CameronBrooks11/geodesic-dome/(list of files, cad)

Other CAD files:
connector.scad
connector_v1.scad
connector_v2.scad
