CameronBrooks11/geodesic-dome/(commit log)

2025-05-18 initial commit of connector concept
    [connector.scad]
2025-05-18 added attrib line
    [connector.scad]
2025-05-18 connector v2, moving towards more uniform and readily parameterizable
    [connector_v1.scad, connector_v2.scad]
2025-05-19 redid center piece to be cleaner and readily parametric
    [connector_v2.scad]
2025-05-19 removed facet helpers to use single var
    [connector_v2.scad]
2025-05-19 renamed facets vars
    [connector_v2.scad]
2025-05-19 removed vestigal vars
    [connector_v2.scad]
2025-05-19 version 3, need to make sides and rotation adjust dynamically based on apothems
    [connector_v1.scad, connector_v2.scad, connector_v3.scad]
2026-11-13 feat: dome hubs from real geodesic geometry, with a build schedule (#1)
    Finish the hub maths: hubs now come from a real geodesic dome, with a
    build schedule, checks and a README.
    ## Before
    `connector_v3.scad` gave every hub N branches at one hand-set tilt
    (100°), so no hub fitted a dome. Its last commit said so: "need to make
    sides and rotation adjust dynamically based on apothems".
    ## Now
    `geodesic_dome.scad` replaces v1–v3 (they stay in the history):
    - **The dome:** a class I icosahedral geodesic at `frequency` and
    `radius`, vertex up. Even frequencies cut flat at the equator. Odd ones
    cut at the highest ring below it plus any ring within 0.05 × radius,
    which at 3V gives the usual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
2026-11-14 chore: relicense under MIT (#2)
    The repository was AGPL-3.0 from its first commit. geodesic_dome.scad
    (#1) replaced connector_v1 to v3 entirely, and none of the tutorial's
    code is in it. The tutorial sets six branches by hand-typed rotations
    (angleX_branch1 to 6, Rotate_all_*) around a scaled sphere. This file
    derives every socket from the dome's geometry, builds the body as a hull
    of the socket bases, and shares none of its code or variable names.
    The tutorial states no licence. Every commit here is mine.
    The README keeps the credit to the tutorial as where the design began.
